FT9R/NixieClock/doc/digispark88_pinout.png

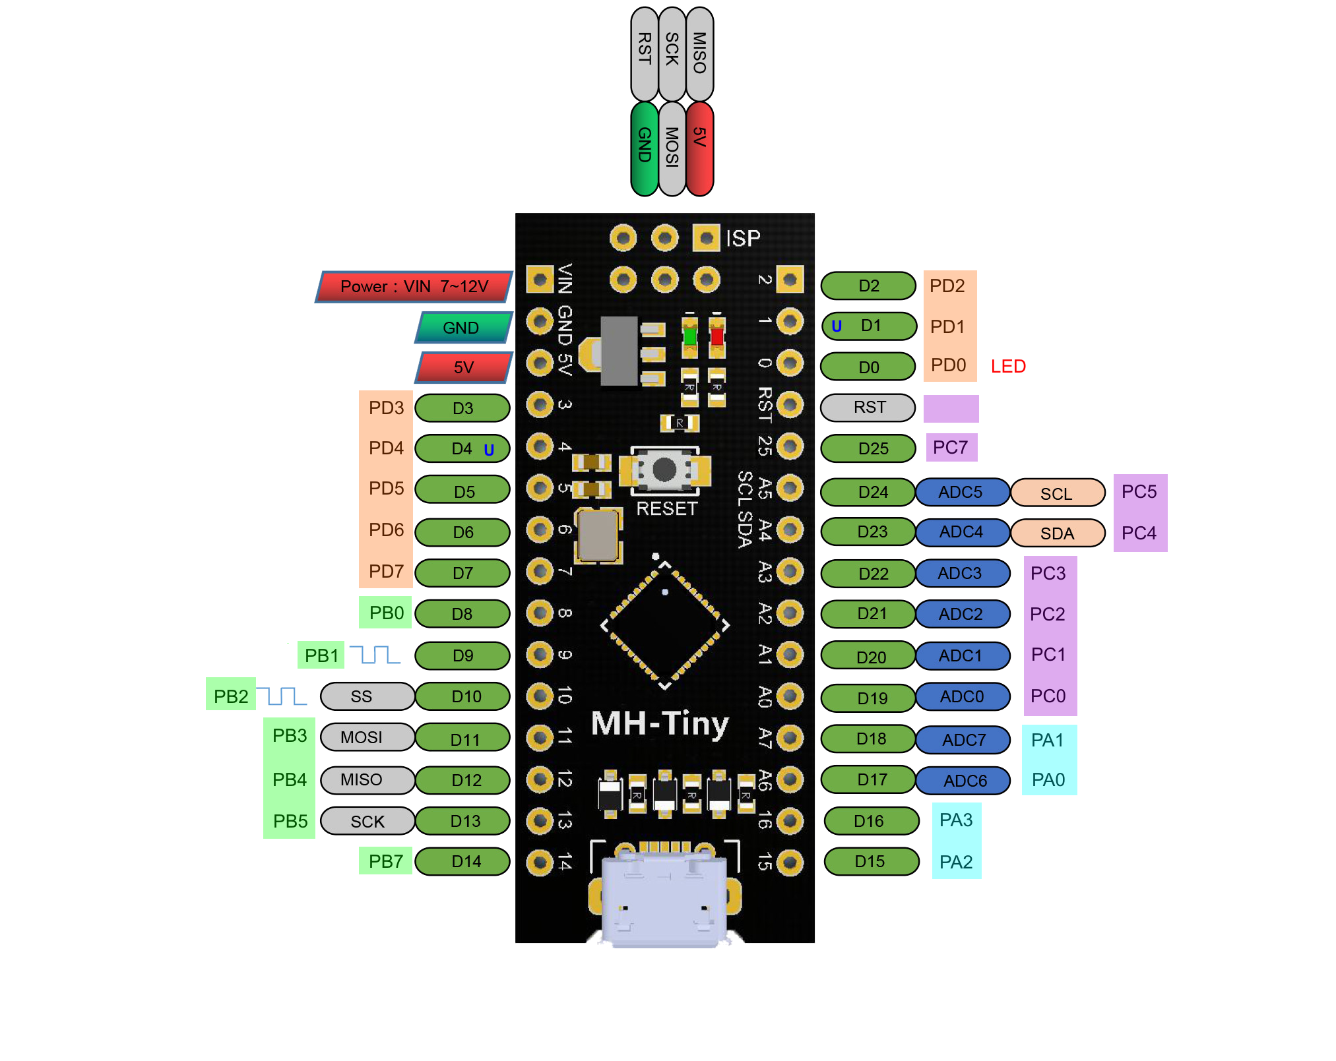
doc/digispark88_pinout.png
