FT9R/NixieClock/images/PCBBottom.JPG

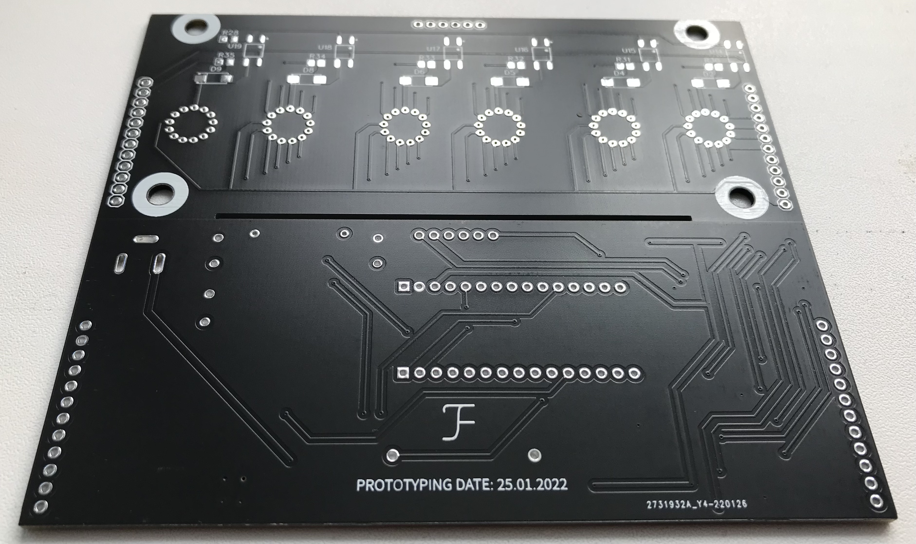
images/PCBBottom.JPG
