FT9R/NixieClock/images/PCBTop.JPG

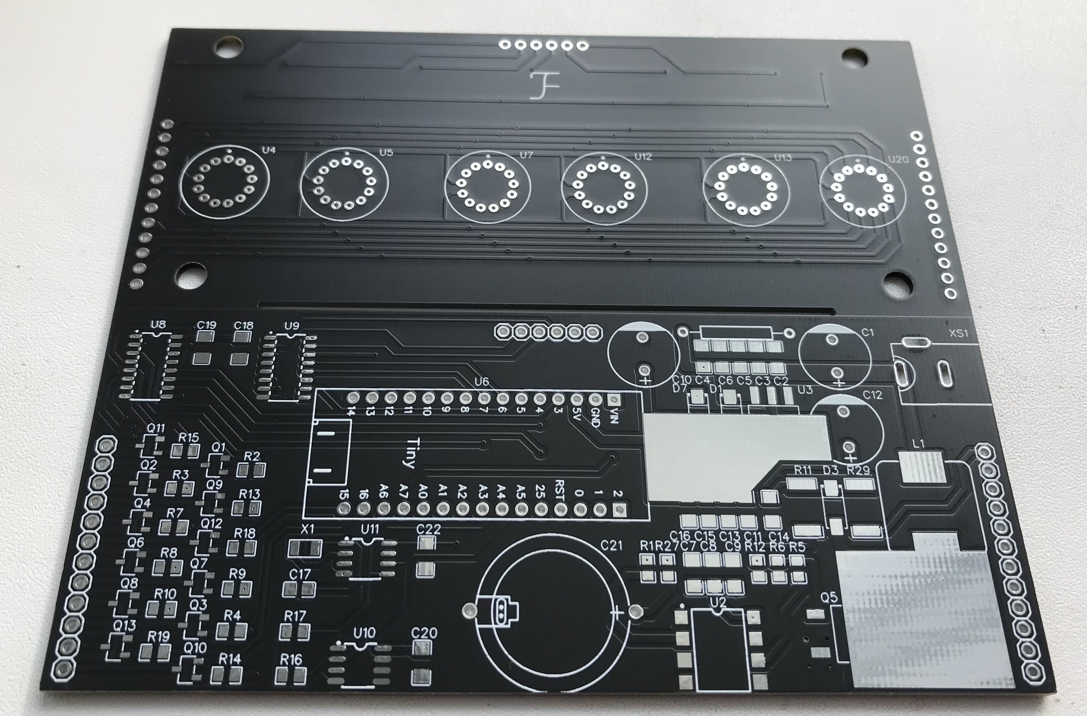
images/PCBTop.JPG
