FT9R/NixieClock/prod_files/Schematic.pdf

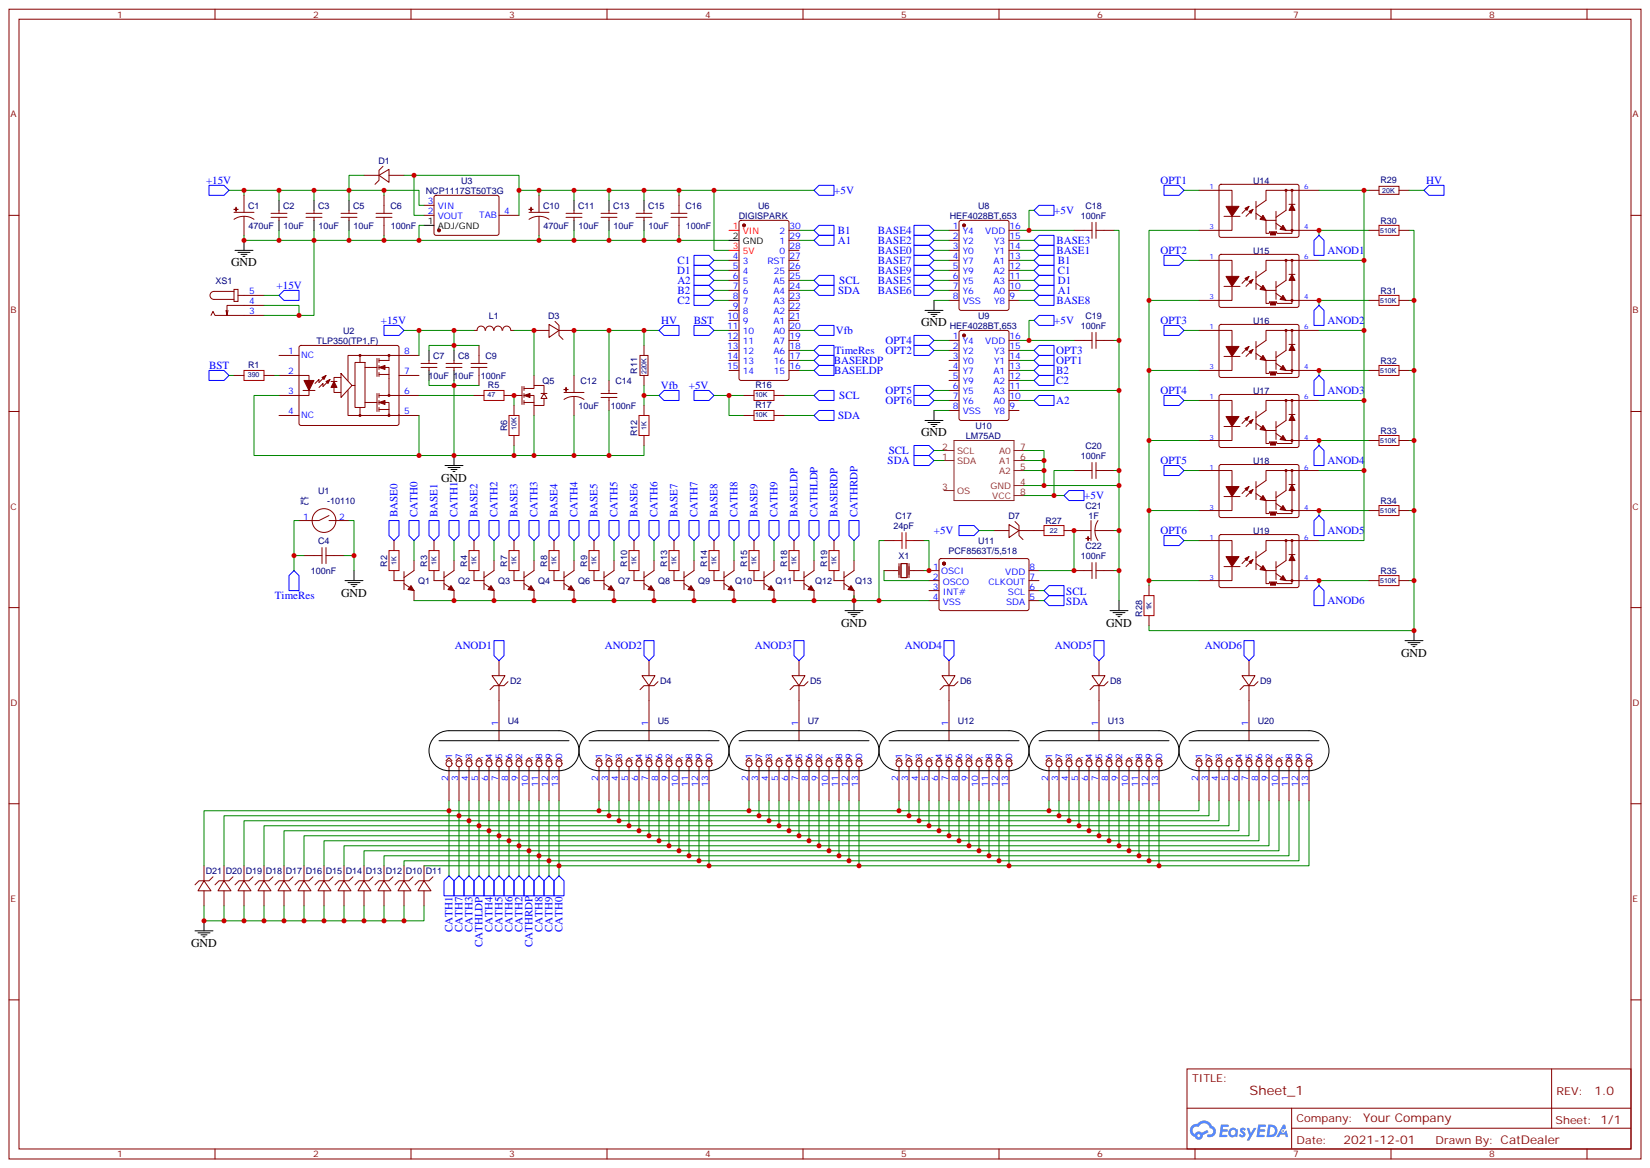
[picture p5: page 1]
