FT9R/NixieClock/(list of files, drawings)

Other design files:
DigisparkPID.pdsprj
