FT9R/NixieClock/images/AssembledBottom.JPG

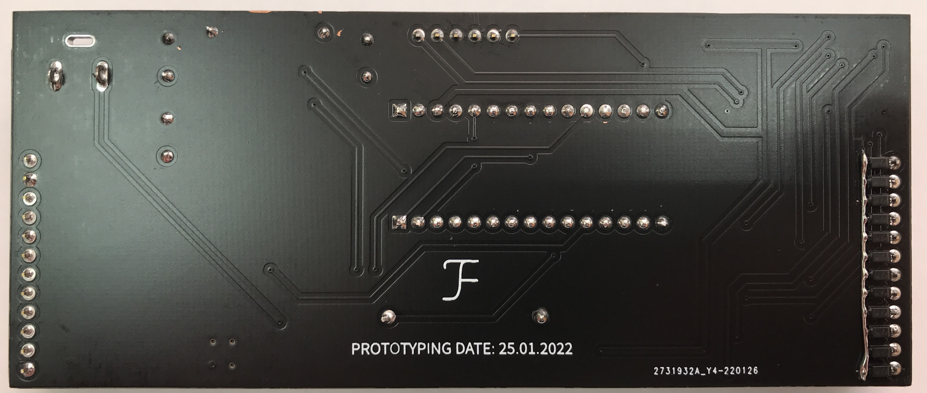
images/AssembledBottom.JPG
