FT9R/NixieClock/images/AssembledTop1.JPG

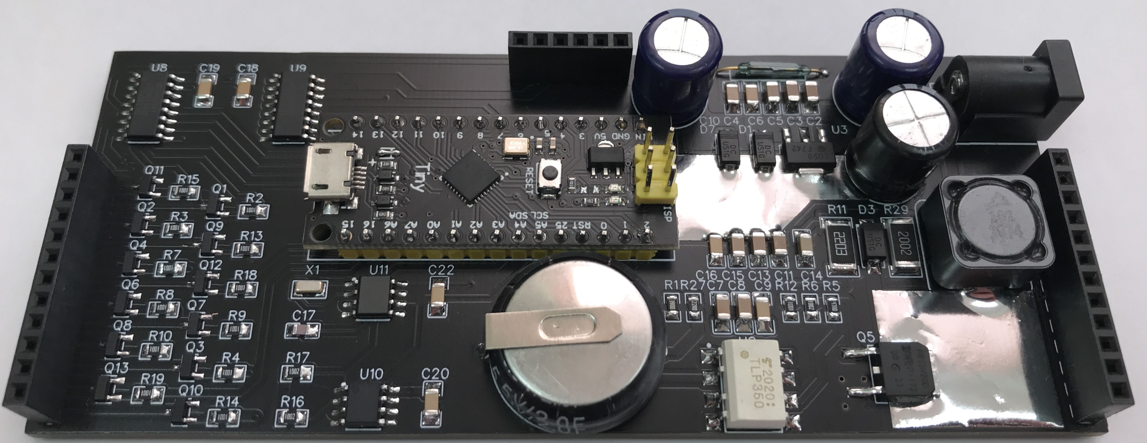
images/AssembledTop1.JPG
