FT9R/NixieClock/images/AssembledTop2.JPG

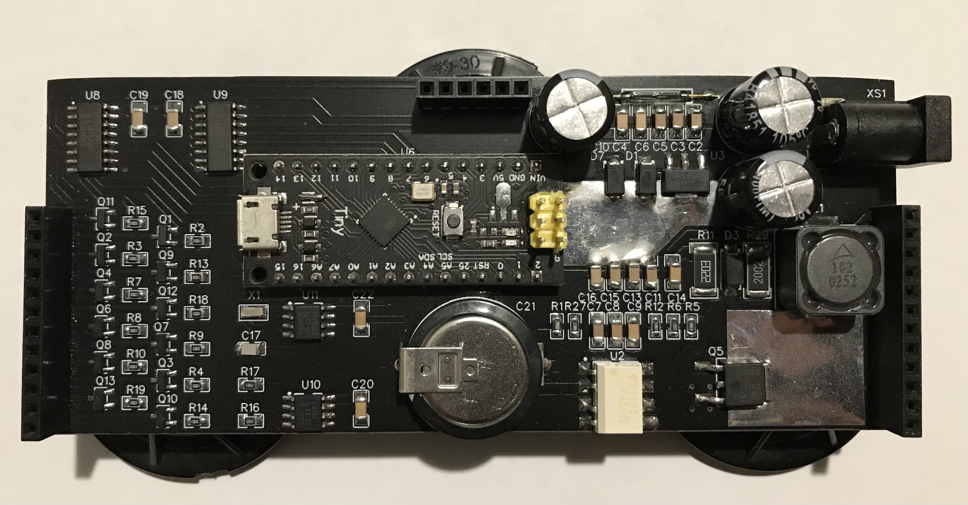
images/AssembledTop2.JPG
