FT9R/NixieClock/Calibration.xlsx

Sheet: LinReg
ВЫВОД ИТОГОВ
Регрессионная статистика
Множественный R | 0.9999965966
R-квадрат | 0.9999931931
Нормированный R-квадрат | 0.9999914914
Стандартная ошибка | 0.09211902894
Наблюдения | 6
Дисперсионный анализ
 | df | SS | MS | F | Значимость F
Регрессия | 1 | 4986.63439 | 4986.63439 | 587636.5837 | 1.737515442e-11
Остаток | 4 | 0.03394366197 | 0.008485915493
Итого | 5 | 4986.668333
 | Коэффициенты | Стандартная ошибка | t-статистика | P-Значение | Нижние 95% | Верхние 95% | Нижние 95,0% | Верхние 95,0%
Y-пересечение | 1.076760563 | 0.1999485403 | 5.385188418 | 0.00574868731 | 0.5216144174 | 1.631906709 | 0.5216144174 | 1.631906709
Переменная X 1 | 1.026408451 | 0.001338954461 | 766.574578 | 1.737515442e-11 | 1.022690917 | 1.030125984 | 1.022690917 | 1.030125984

Sheet: Sheet1
Vtask | Vmeas | Vcal
180 | 185.9 | 180.0402206
170 | 175.6 | 170.0052291
160 | 165.3 | 159.9702377
150 | 154.9 | 149.8378192
120 | 124.2 | 119.9276991
100 | 103.8 | 100.0525705
