FT9R/NixieClock/(commit log)

2024-02-21 rebuild with cmake
    [BOM.csv, DigisparkPID.pdsprj]
2024-02-21 new cad system
2024-02-21 cad glitch elimination approach
    [dataTypes.h, definitions.h, main.c]
2024-02-29 Vout adc calibration
    [Calibration.xlsx]
2024-02-29 new data type for temperature
